Am0k-GIT/Halcyon/docs/Schematic_FilamentSensor.pdf

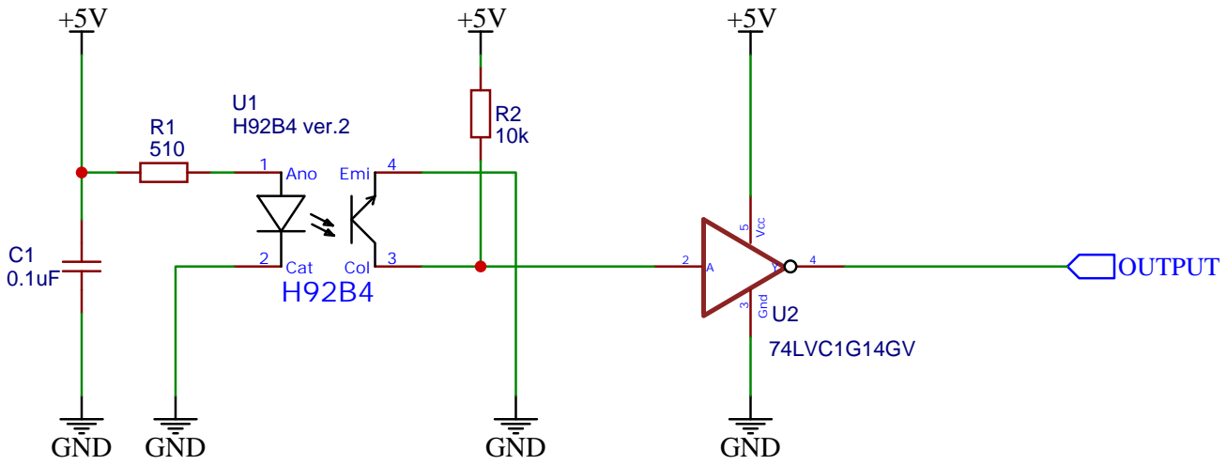
[picture p9: figure]
H92B4 ver.2; Cat 2; Ano 1; Emi 4; Col 3 H92B4; GND; 74LVC1G14GV; Gnd; Vcc; OUTPUT

## C1 XH⁻².54 3pin

FILAMENT1

1

2

3

+5V

GND

OUTPUT
