Am0k-GIT/Halcyon/docs/Schematic_PowerManager.pdf

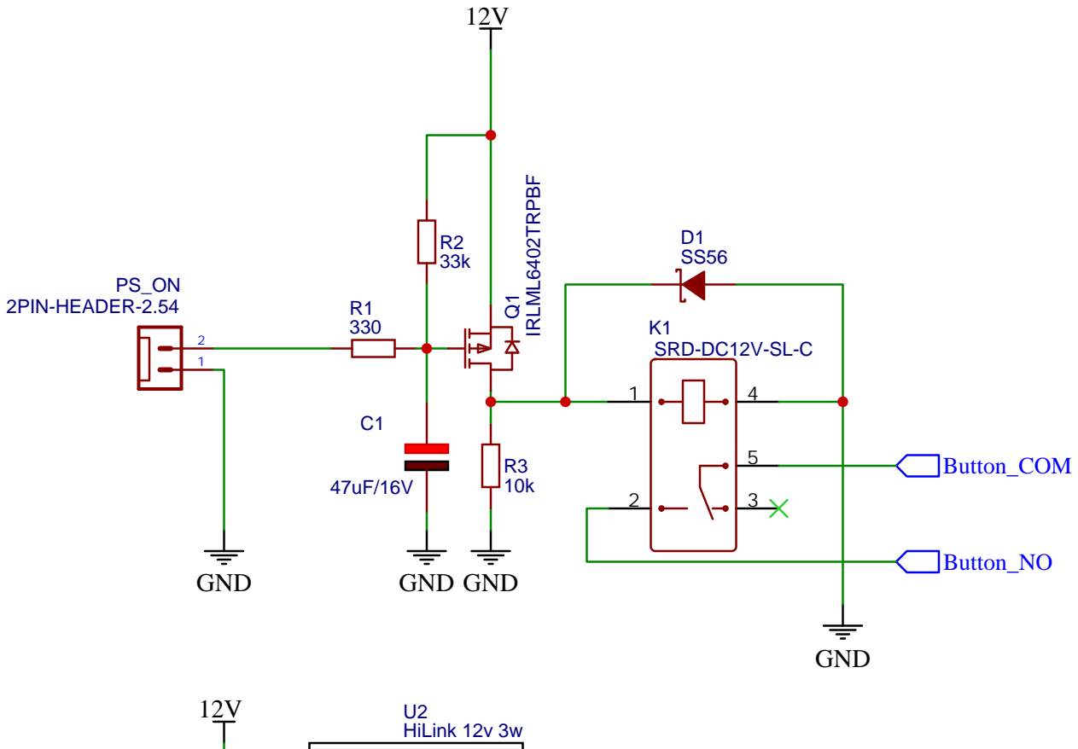
[picture p10: figure]
2PIN-HEADER-2.54; GND; SRD-DC12V-SL-C; HiLink 12v 3w; IRLML6402TRPBF; Button_COM; Button_NO
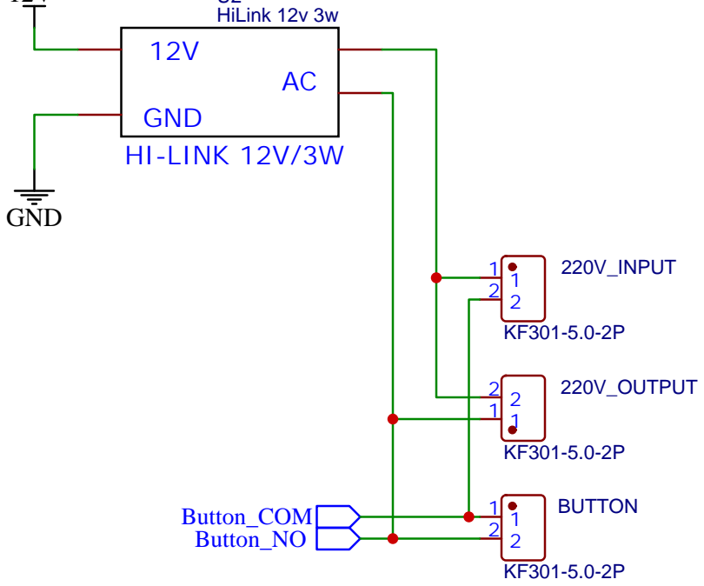
[picture p11: figure]
HI-LINK 12V/3W; GND; 220V_INPUT 1; 220V_OUTPUT; BUTTON 1; Button_COM Button_NO
