Am0k-GIT/Halcyon/docs/Schematic_Halcyon_v1.pdf

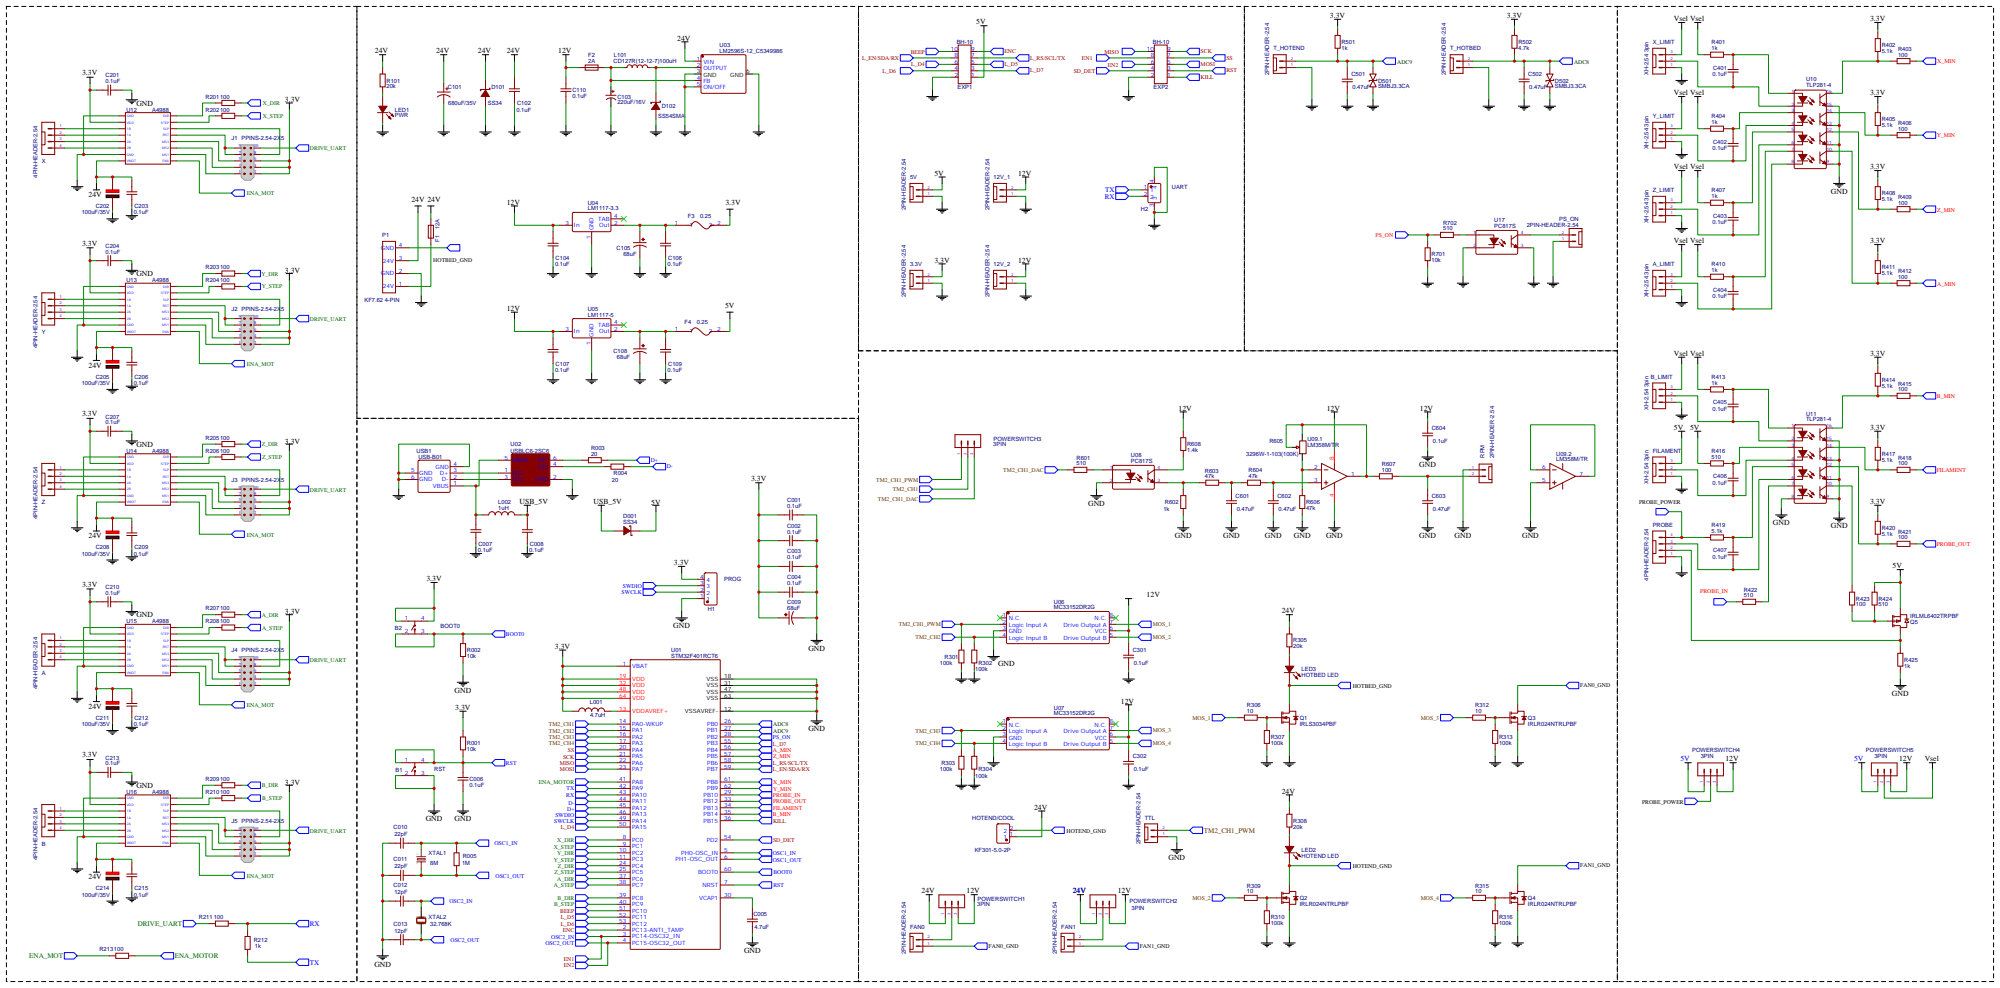
[picture p18: page 1]
