Am0k-GIT/Halcyon/docs/dimension.pdf

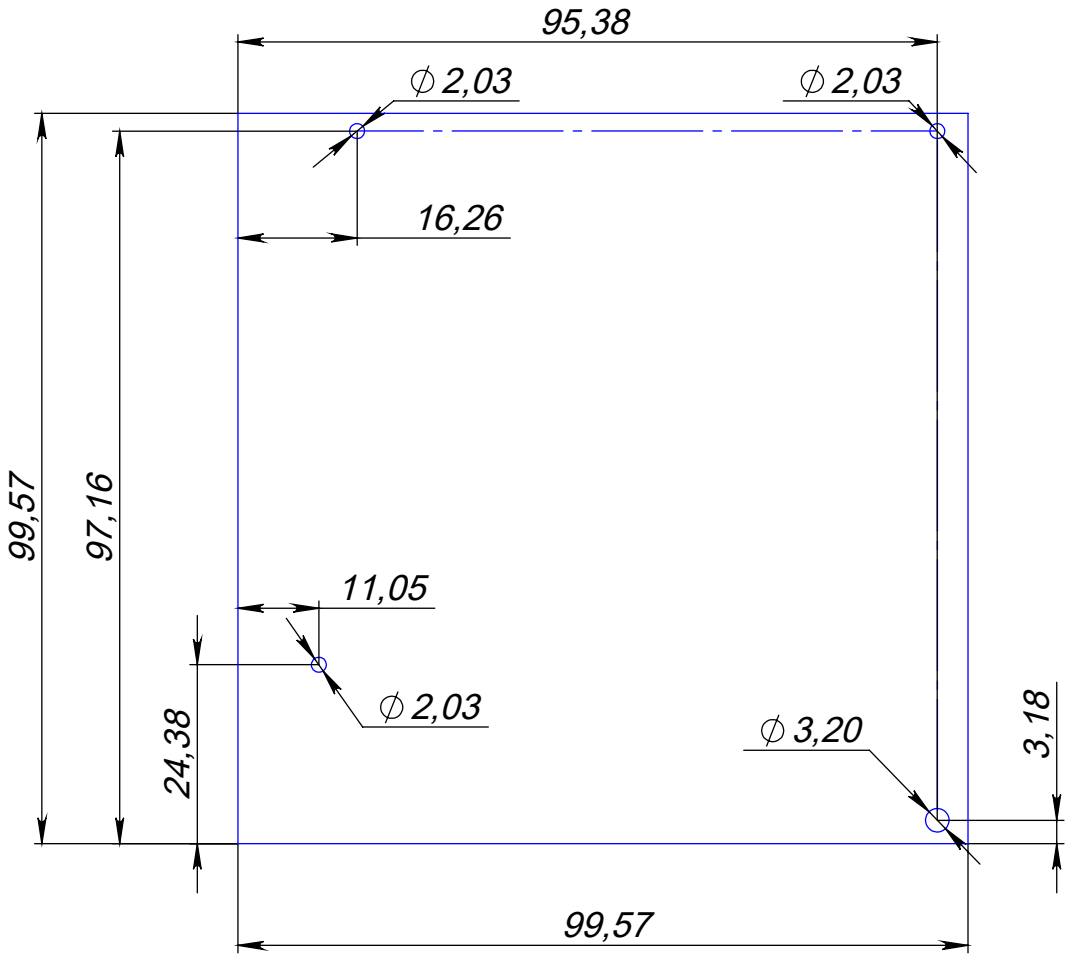
[picture p19: page 1]
