Am0k-GIT/Halcyon/(list of files, drawings)

Other design files:
EasyEDA/PCB_PCB_2023-10-01.json
EasyEDA/SCH_Halcyon_2023-10-01.json
