Am0k-GIT/Halcyon/(commit log)

2023-06-12 add README for Marlin
2023-06-12 update Readme and files for Marlin
2023-11-05 Update Schematic_Halcyon_v1.pdf
    Fix label P1.
2025-08-31 Update GRBL and instructions
    [config.h]
2026-01-04 add STM32F401RE version bootloader
2026-01-06 add STM32F401RE support and information
2026-07-30 update Marlin 2.1.2.8
