Am0k-GIT/Halcyon/(notices)

Notices in the files:
Software/Marlin/files/Marlin/src/pins/stm32f4/pins_HALCYON_V1.h:
This program is free software: you can redistribute it and/or modify
it under the terms of the GNU General Public License as published by
the Free Software Foundation, either version 3 of the License, or
(at your option) any later version.
